Edutar/FC/photo_1_2025-01-22_01-13-42.jpg

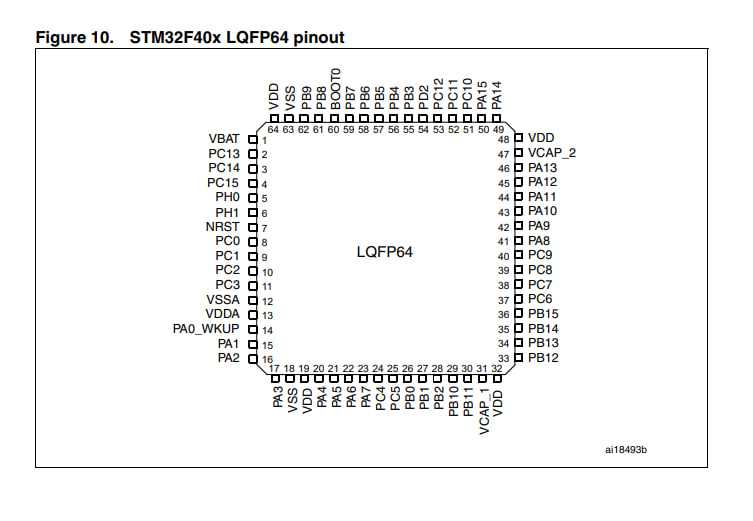
photo_1_2025-01-22_01-13-42.jpg
