Edutar/FC/photo_2_2025-01-22_01-13-42.jpg

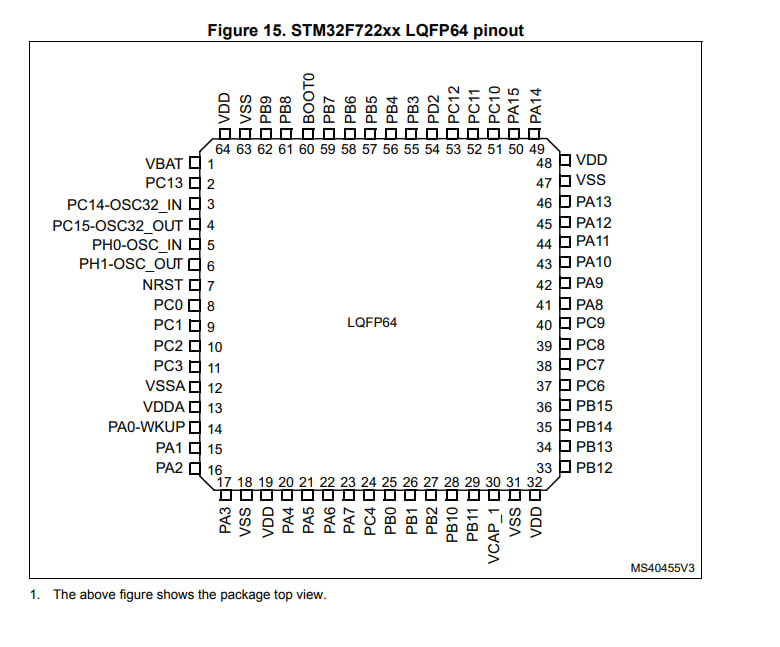
photo_2_2025-01-22_01-13-42.jpg
