Edutar/FC/photo_3_2025-01-22_01-13-42.jpg

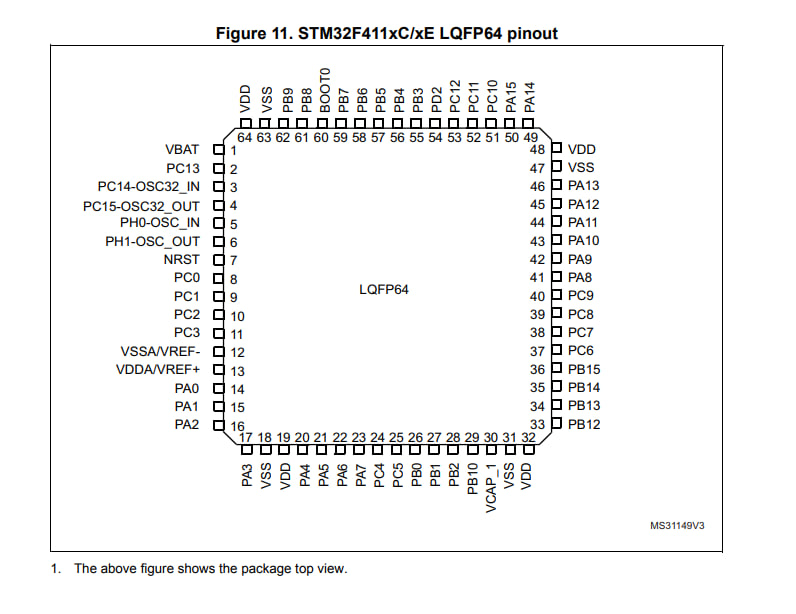
photo_3_2025-01-22_01-13-42.jpg
