Edutar/FC/photo_4_2025-01-22_01-13-42.jpg

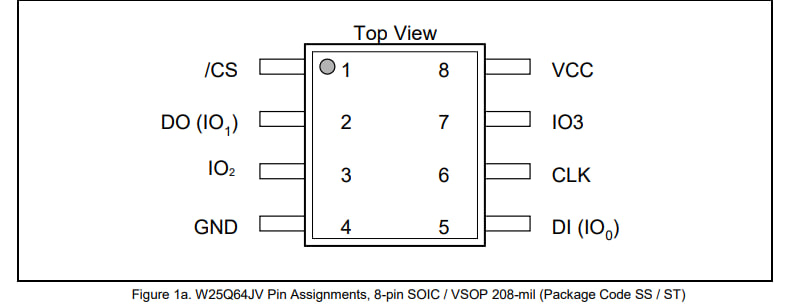
photo_4_2025-01-22_01-13-42.jpg
