Edutar/FC/photo_5_2025-01-22_01-13-42.jpg

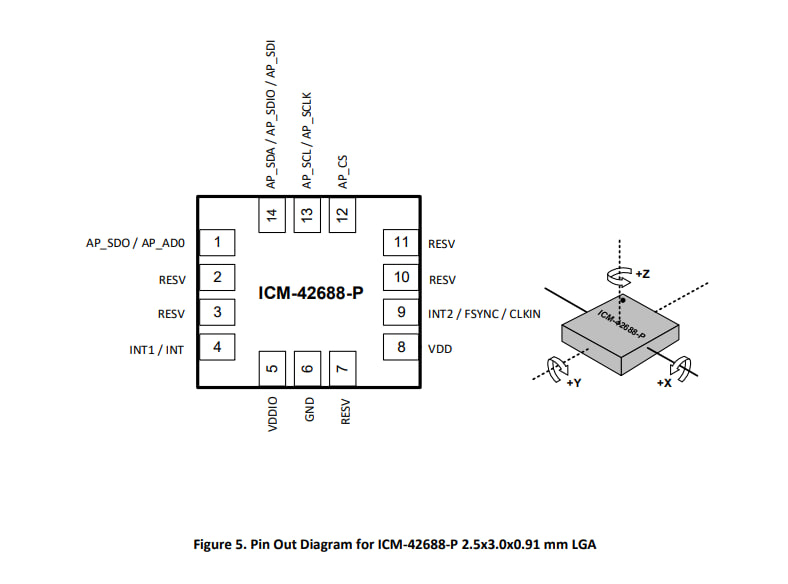
photo_5_2025-01-22_01-13-42.jpg
