Edutar/FC/photo_6_2025-01-22_01-13-42.jpg

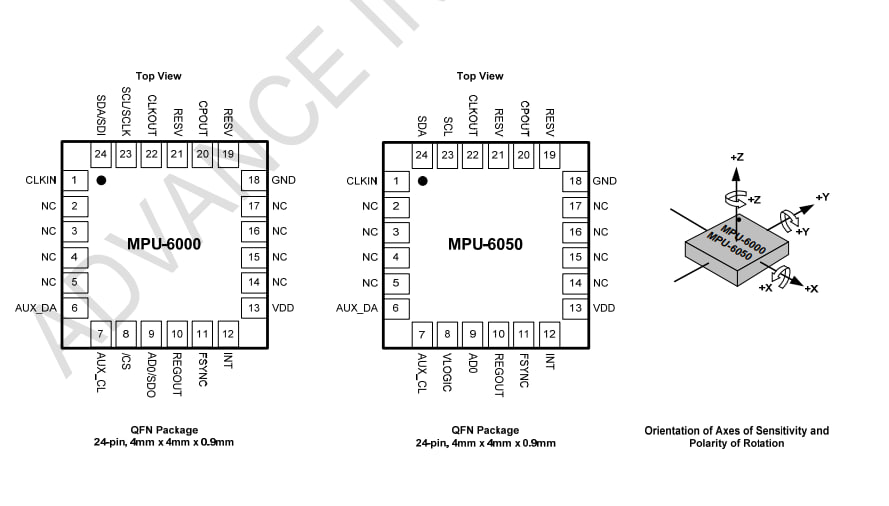
photo_6_2025-01-22_01-13-42.jpg
