Edutar/FC/photo_7_2025-01-22_01-13-42.jpg

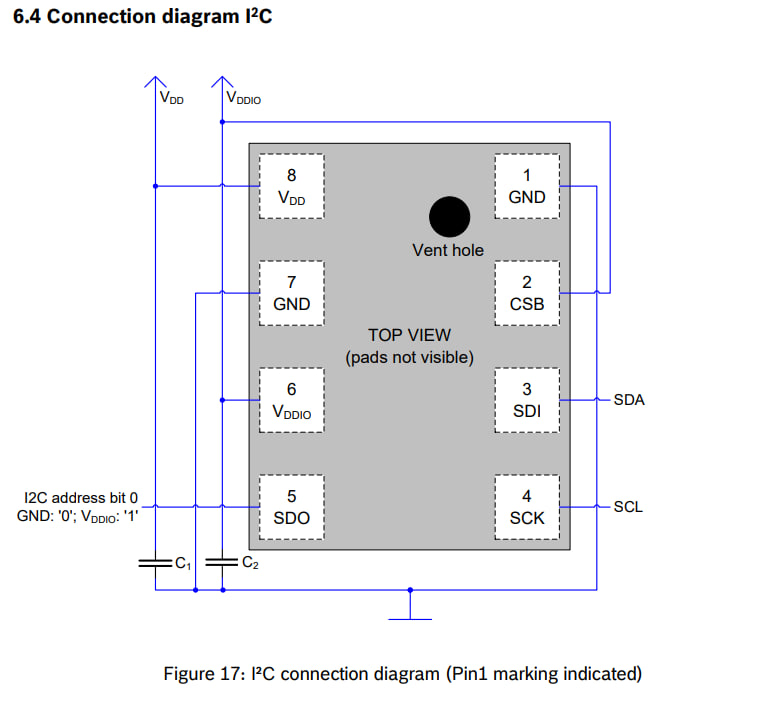
photo_7_2025-01-22_01-13-42.jpg
