Edutar/FC/photo_8_2025-01-22_01-13-42.jpg

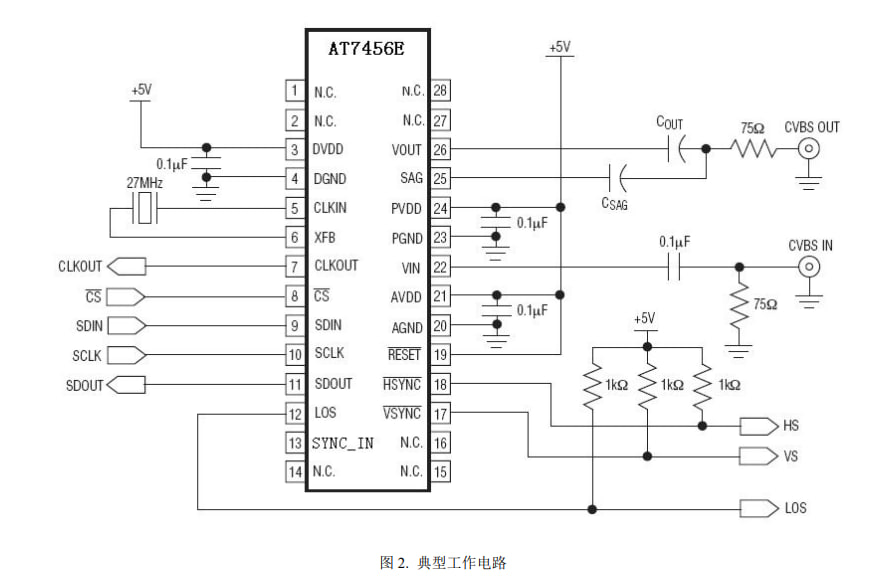
photo_8_2025-01-22_01-13-42.jpg
