Edutar/FC/photo_9_2025-01-22_01-13-42.jpg

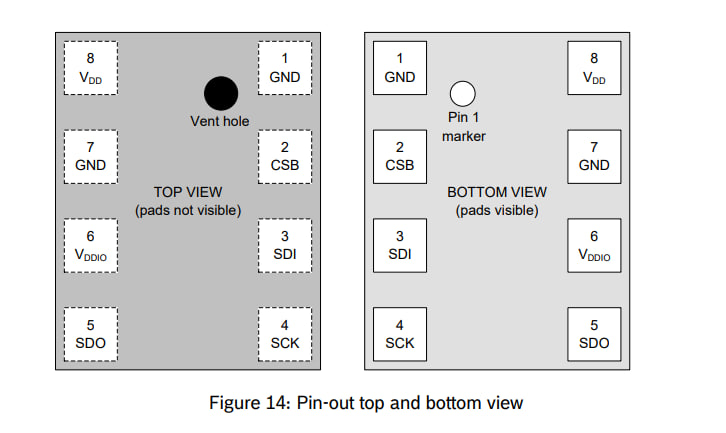
photo_9_2025-01-22_01-13-42.jpg
