Edutar/FC/pcb/AT7456E/AT7456E/3D/AT7456E.stp

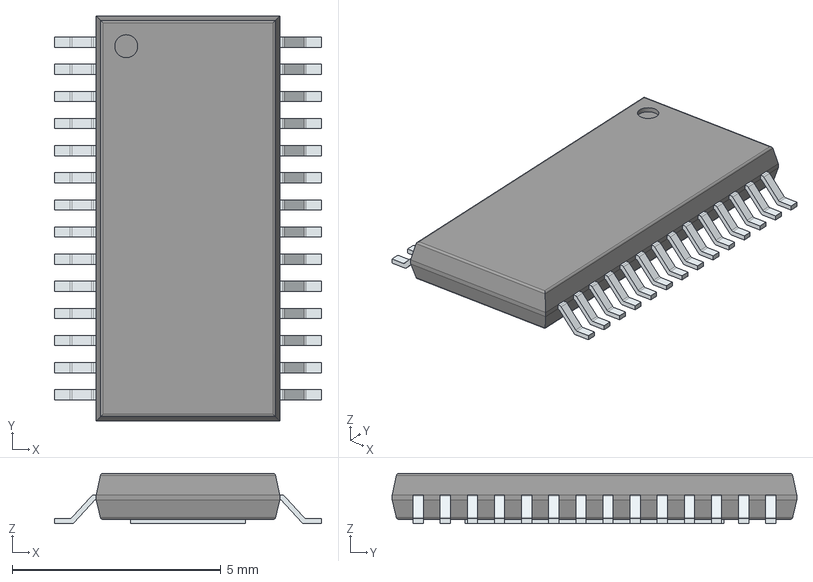
[picture p10: CAD file, 2025-05-21]
pcb/AT7456E/AT7456E/3D/AT7456E.stp
6.40 x 9.70 x 1.20 mm
PinsArrayLR
ThermalPad
