Edutar/FC/pcb/Crystal/ASV-27.000MHZ-EJ-T/ASV-27.000MHZ-EJ-T.step

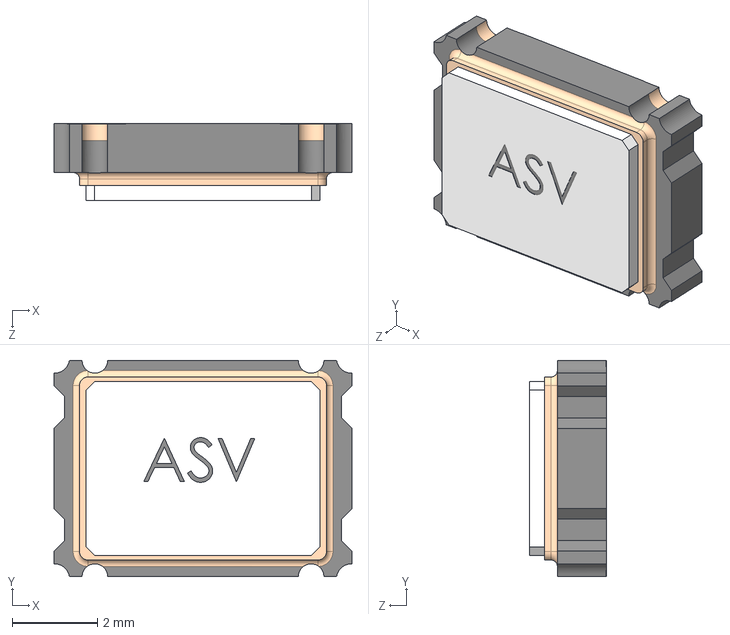
[picture p11: CAD file, 2025-05-21]
pcb/Crystal/ASV-27.000MHZ-EJ-T/ASV-27.000MHZ-EJ-T.step
7.00 x 5.08 x 1.80 mm
