Edutar/FC/pcb/crystal2/C5S-8.000-16-3030-X-R/C5S-8.000-16-3030-X-R.step

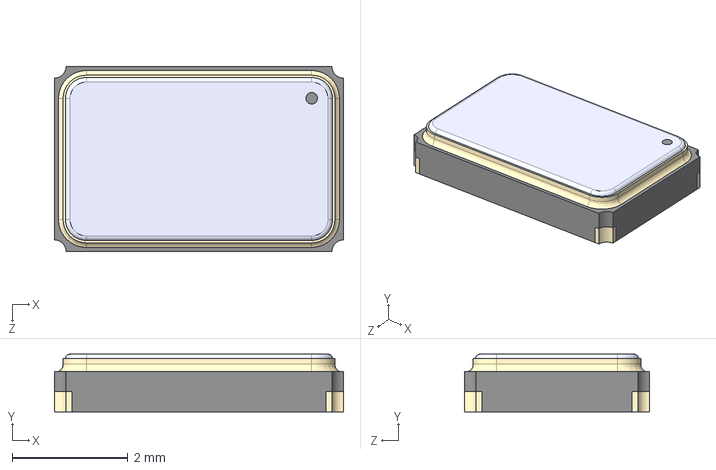
[picture p12: CAD file, 2025-05-21]
pcb/crystal2/C5S-8.000-16-3030-X-R/C5S-8.000-16-3030-X-R.step
5.00 x 1.00 x 3.20 mm
