Edutar/FC/pcb/ICM-42688/ICM-45686/ICM-45686.step

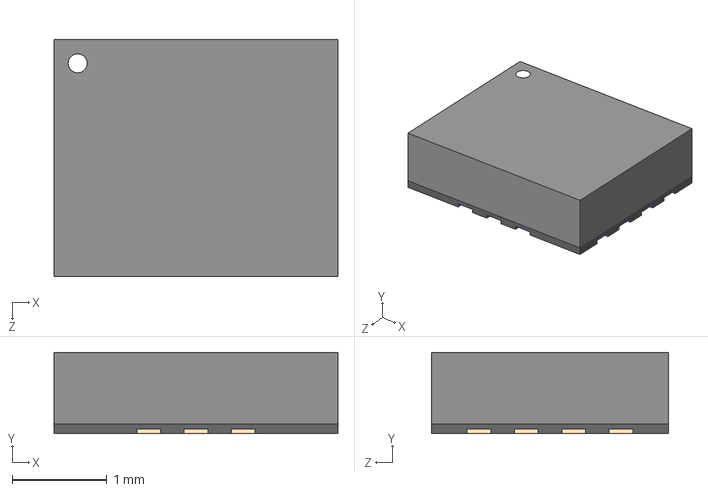
[picture p13: CAD file, 2025-05-21]
pcb/ICM-42688/ICM-45686/ICM-45686.step
3.00 x 0.86 x 2.50 mm
