Edutar/FC/pcb/inductance/F1D1-060603W-100M/F1D1-060603W-100M.step

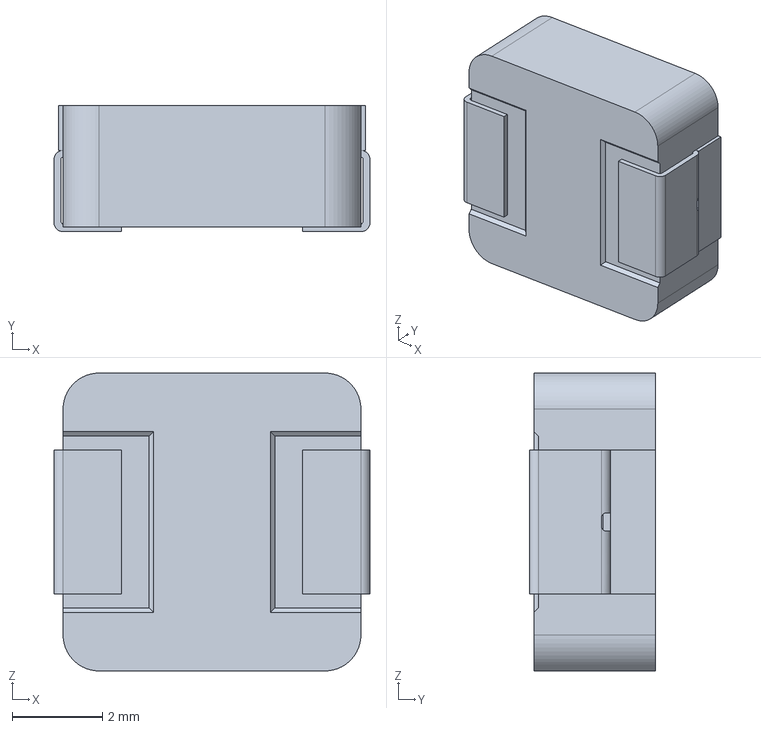
[picture p14: CAD file, 2025-05-21]
pcb/inductance/F1D1-060603W-100M/F1D1-060603W-100M.step
7.00 x 2.80 x 6.60 mm
