Edutar/FC/pcb/MAX4544EUT/MAX4544EUT_T/MAX4544EUT_T.step

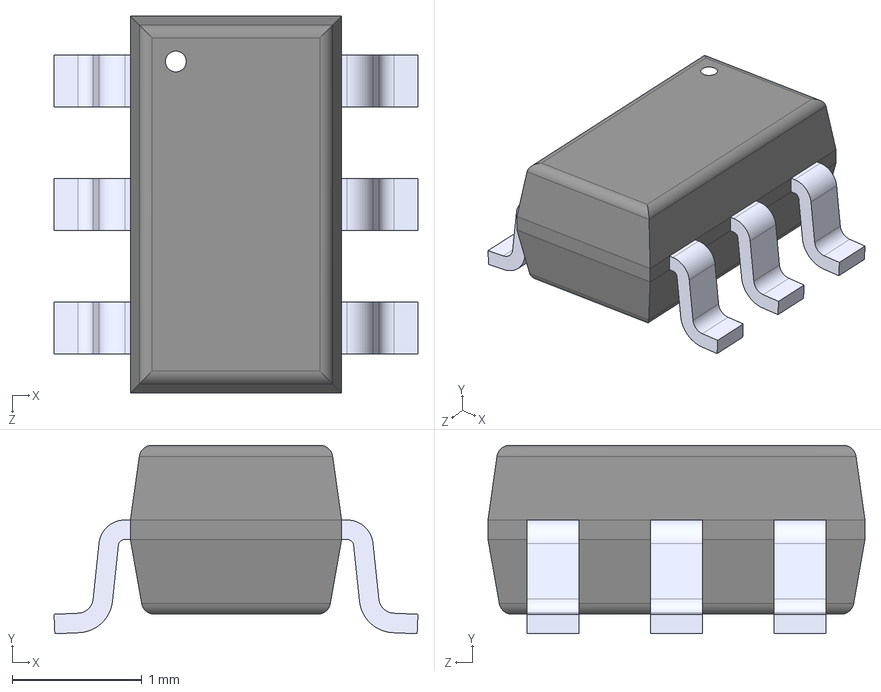
[picture p15: CAD file, 2025-05-21]
pcb/MAX4544EUT/MAX4544EUT_T/MAX4544EUT_T.step
2.80 x 1.45 x 2.90 mm
