Edutar/FC/pcb/MP1584EN/MP1584EN.step

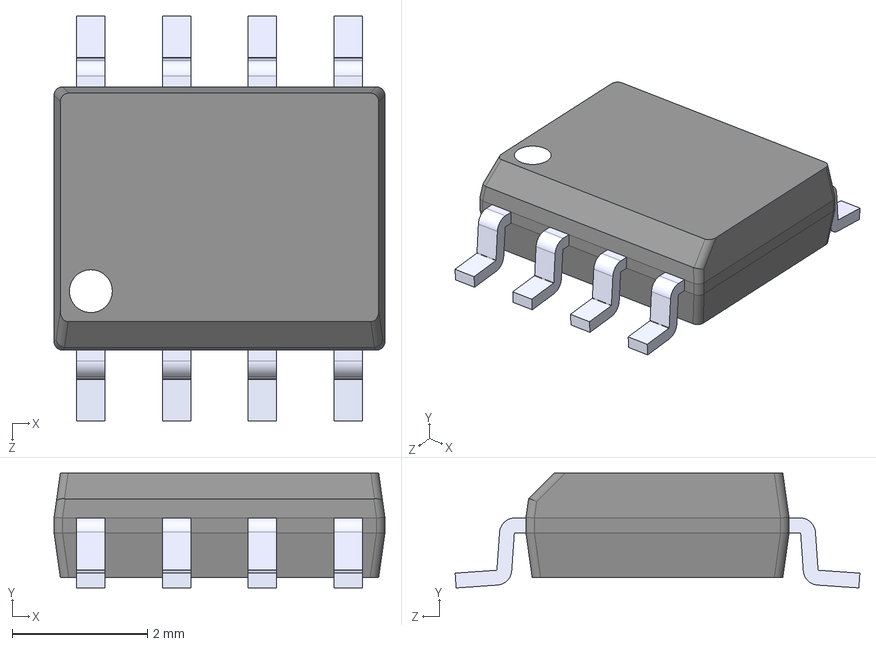
[picture p16: CAD file, 2025-05-21]
pcb/MP1584EN/MP1584EN.step
4.90 x 1.70 x 5.99 mm
