Edutar/FC/(list of files, cad)

Other CAD files:
pcb/AT7456E/AT7456E/Allegro/sop65p640x120-29n.psm
pcb/AT7456E/AT7456E/DEHDL/at7456e/chips/chips.prt
