Edutar/FC/Збірка під stellar PCB/Збірка/Збірка.kicad_pcb

## KiCad design Збірка під stellar PCB/Збірка/Збірка.kicad_pcb (2025-05-21)

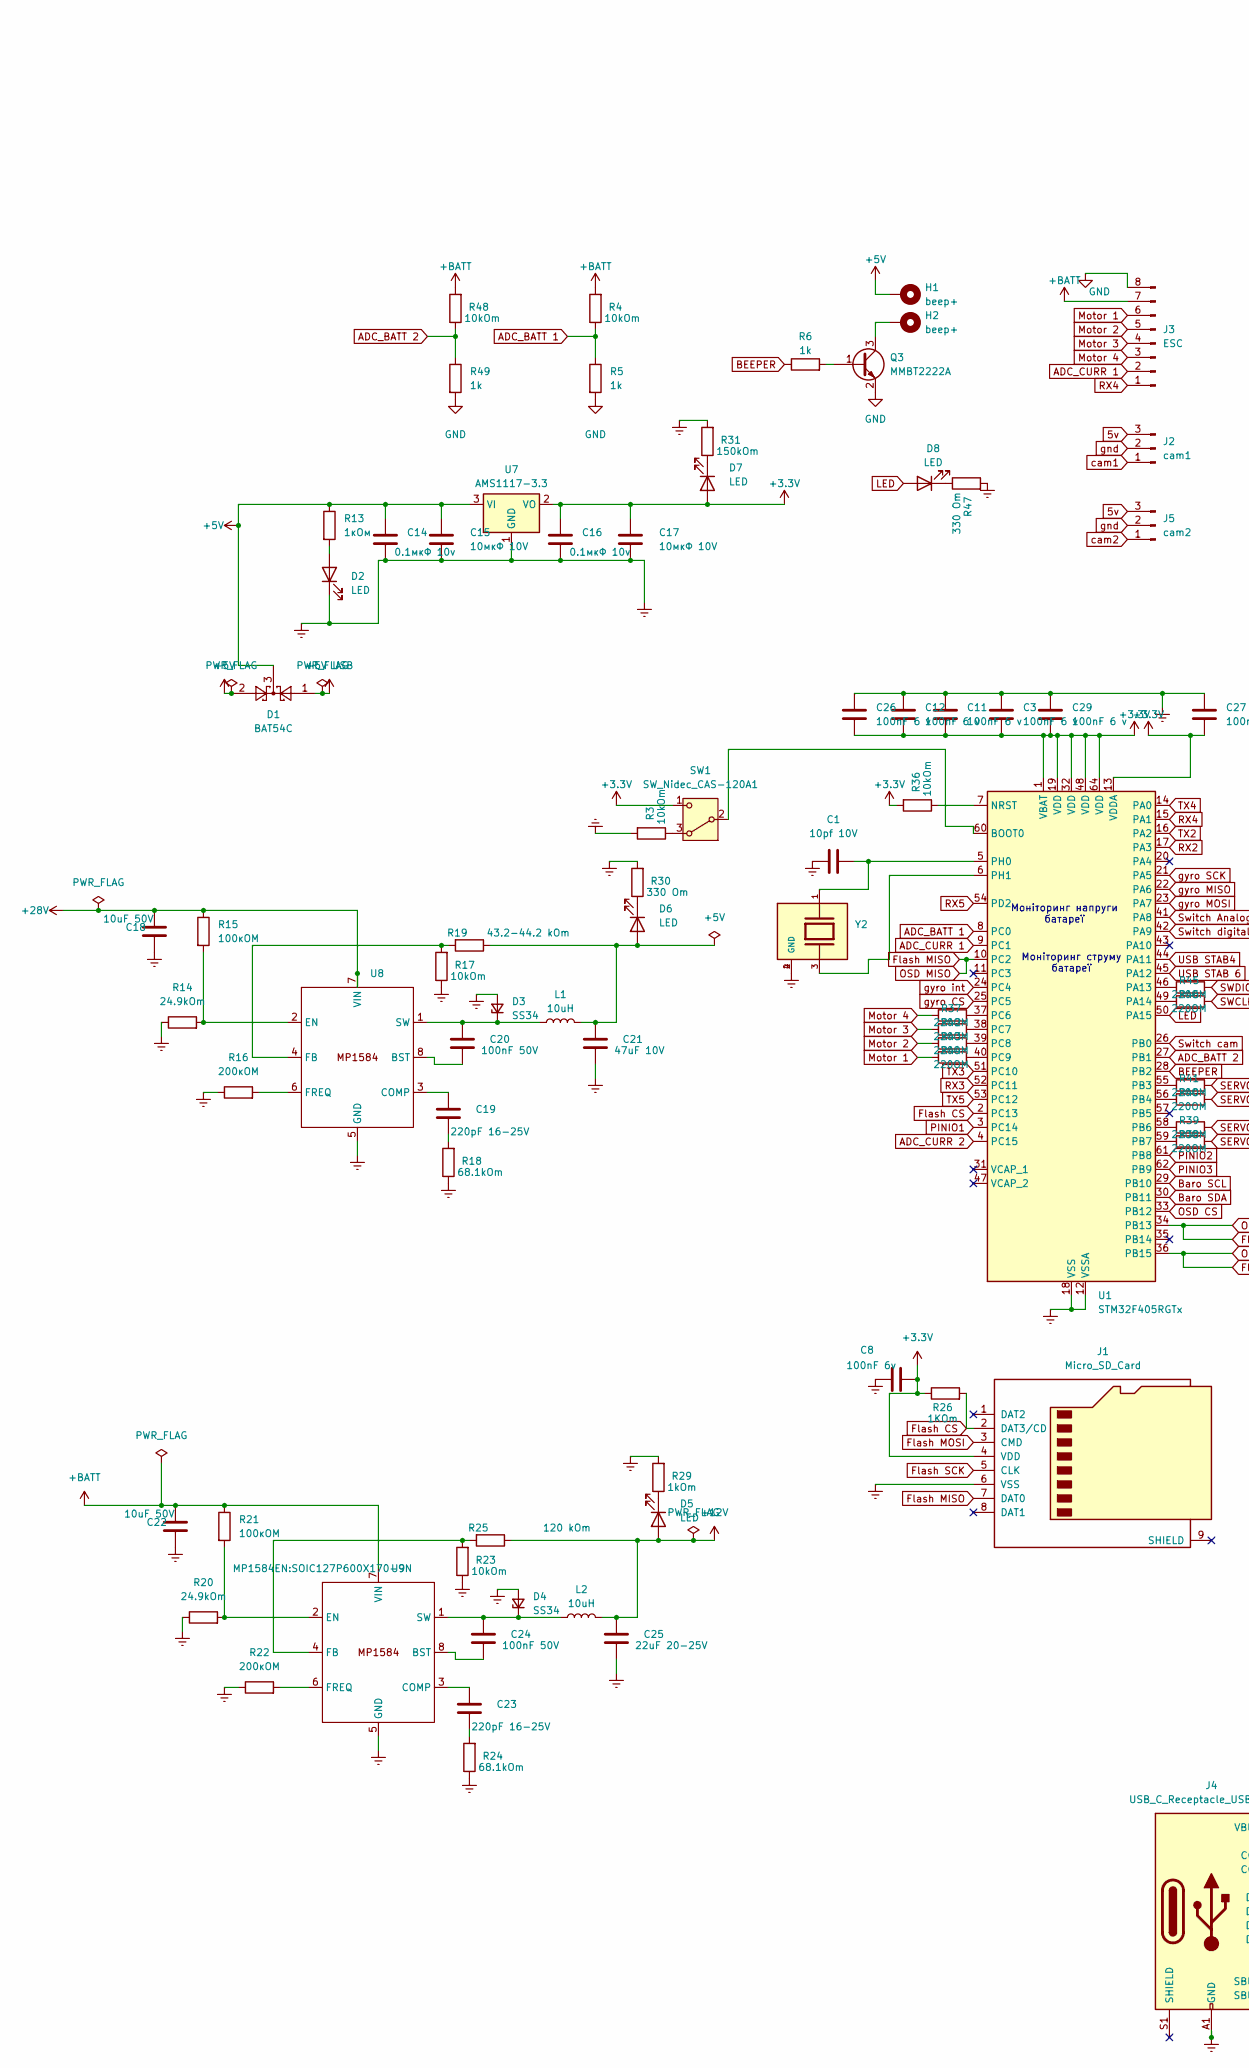
[picture p17: schematic Збірка.kicad_sch, part in row 1, column 1]

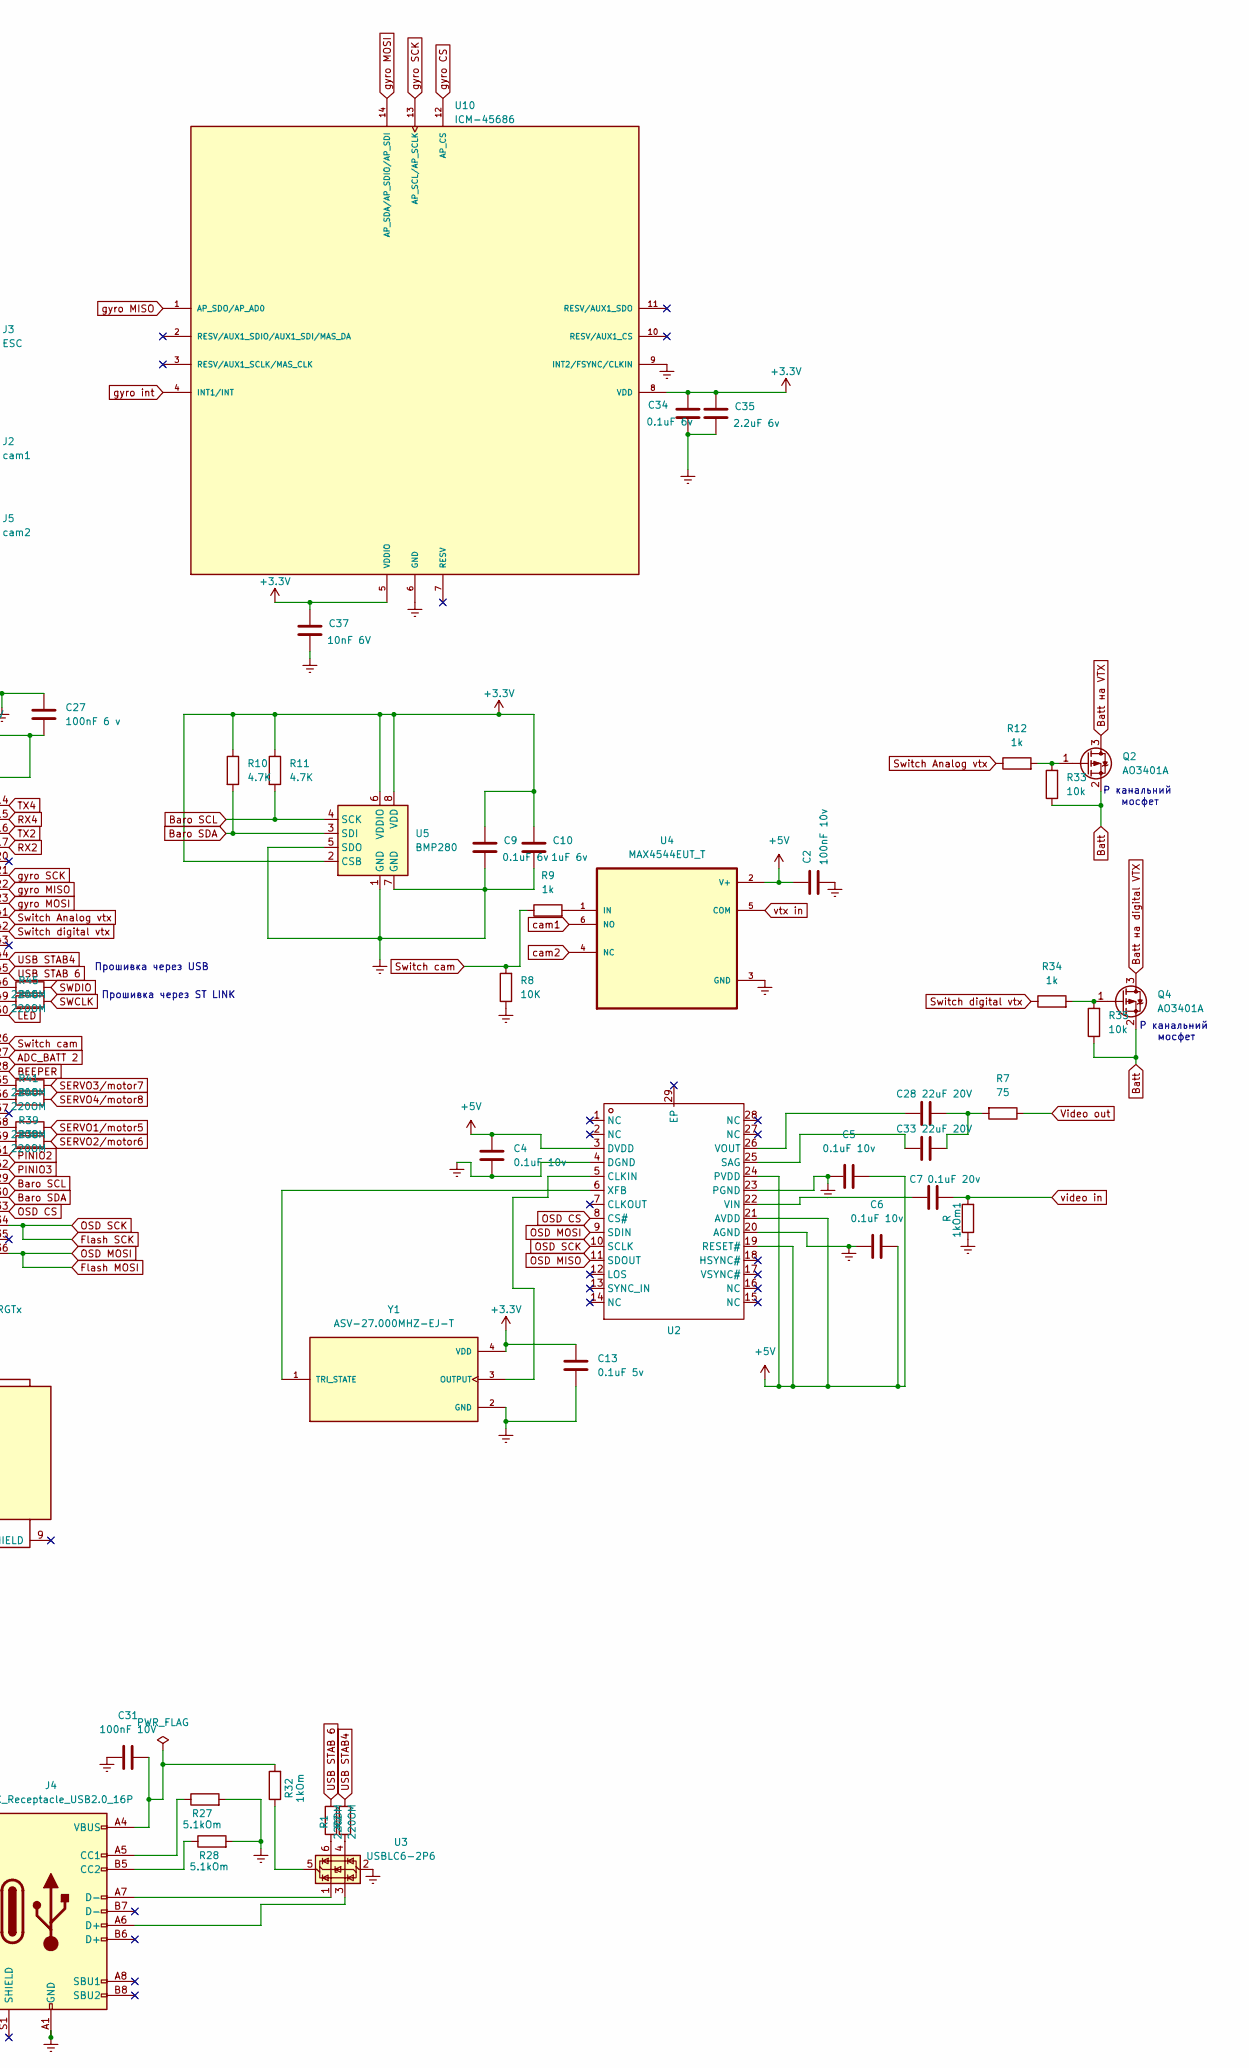
[picture p18: schematic Збірка.kicad_sch, part in row 1, column 2]

Parts:
1kOm1: R; R_0402_1005Metric_Pad0.72x0.64mm_HandSolder
C1: 10pf 10V; C_0603_1608Metric_Pad1.08x0.95mm_HandSolder
C2: 100nF 10v; C_0603_1608Metric
C3, C11, C12, C26, C27, C29: 100nF 6 v; C_0603_1608Metric
C4, C5, C6: 0.1uF 10v; C_0805_2012Metric_Pad1.18x1.45mm_HandSolder
C7: 0.1uF 20v; C_0805_2012Metric
C8: 100nF 6v; C_0402_1005Metric
C9: 0.1uF 6v; C_0603_1608Metric
C10: 1uF 6v; C_0603_1608Metric
C13: 0.1uF 5v; C_0603_1608Metric
C14, C16: 0.1мкФ 10v; C_0603_1608Metric
C15, C17: 10мкФ 10V; C_0805_2012Metric
C18, C22: 10uF 50V; C_1210_3225Metric
C19, C23: 220pF 16-25V; C_1206_3216Metric
C20, C24: 100nF 50V; C_1210_3225Metric
C21: 47uF 10V; C_0805_2012Metric_Pad1.18x1.45mm_HandSolder
C25: 22uF 20-25V; C_1206_3216Metric
C28, C33: 22uF 20V; C_0805_2012Metric_Pad1.18x1.45mm_HandSolder
C31: 100nF 10V; C_0805_2012Metric
C34: 0.1uF 6v; C_0402_1005Metric
C35: 2.2uF 6v; C_0402_1005Metric
C37: 10nF 6V; C_0603_1608Metric
D1: BAT54C; SOT-23
D2, D5, D6, D7, D8: LED; LED_0402_1005Metric
D3, D4: SS34; D_SMA
H1, H2: beep+; SolderWirePad_1x01_SMD_1x2mm
J1: Micro_SD_Card; microSD_HC_Molex_47219-2001
J2: cam1; Samtec_T1M-03-X-S-RA_1x03-1MP_P1.0mm_Terminal_Horizontal
J3: ESC; Molex_200528-0080_1x08-1MP_P1.00mm_Horizontal
J4: USB_C_Receptacle_USB2.0_16P; USB_C_Receptacle_GCT_USB4105-xx-A_16P_TopMnt_Horizontal
J5: cam2; Samtec_T1M-03-X-S-RA_1x03-1MP_P1.0mm_Terminal_Horizontal
L1, L2: 10uH; IND_F1D1-060603W-100M
Q2, Q4: AO3401A; SOT-23
Q3: MMBT2222A; SOT-23
R1, R2, R37, R38, R39, R40, R41, R42, R43, R44, R45, R46: 220OM; R_0201_0603Metric
R3, R4, R17, R23, R36, R48: 10kOm; R_0402_1005Metric_Pad0.72x0.64mm_HandSolder
R5, R6, R9, R12, R34, R49: 1k; R_0201_0603Metric
R7: 75; R_0201_0603Metric
R8: 10K; R_0402_1005Metric_Pad0.72x0.64mm_HandSolder
R10, R11: 4.7K; R_0402_1005Metric
R13: 1кОм; R_0402_1005Metric_Pad0.72x0.64mm_HandSolder
R14, R20: 24.9kOm; R_0402_1005Metric_Pad0.72x0.64mm_HandSolder
R15: 100кОМ; R_0603_1608Metric_Pad0.98x0.95mm_HandSolder
R16, R22: 200кОМ; R_0603_1608Metric_Pad0.98x0.95mm_HandSolder
R18, R24: 68.1kOm; R_0402_1005Metric_Pad0.72x0.64mm_HandSolder
R19: 43.2-44.2 kOm; R_0603_1608Metric
R21: 100кОМ; R_0603_1608Metric
R25: 120 kOm; R_0603_1608Metric
R26: 1KOm; R_0402_1005Metric_Pad0.72x0.64mm_HandSolder
R27, R28: 5.1kOm; R_0402_1005Metric
R29, R32: 1kOm; R_0201_0603Metric
R30, R47: 330 Om; R_0201_0603Metric
R31: 150kOm; R_0201_0603Metric
R33, R35: 10k; R_0402_1005Metric_Pad0.72x0.64mm_HandSolder
SW1: SW_Nidec_CAS-120A1; Nidec_Copal_CAS-120A
U1: STM32F405RGTx; LQFP-64_10x10mm_P0.5mm
U2: SOP65P640X120-29N; Manufacturer Part AT7456E; LCSC Part Name AT7456E
U3: USBLC6-2P6; SOT-666
U4: MAX4544EUT_T; SOT95P280X145-6N
U5: BMP280; Bosch_LGA-8_2x2.5mm_P0.65mm_ClockwisePinNumbering
U7: AMS1117-3.3; SOT-223-3_TabPin2
U8, U9: SOIC127P600X170-9N
U10: ICM-45686; IC_ICM-45686; PARTREV 0.2
Y1: ASV-27.000MHZ-EJ-T; XTAL_ASV-27.000MHZ-EJ-T; PARTREV 09.02.14
Y2: C5S-8.000-16-3030-X-R; XTAL_C5S-8.000-16-3030-X-R; PARTREV N/A

Connections:
5v: J2.3, J5.3
+3.3V: C3.1, C8.2, C9.1, C10.1, C11.1, C12.1, C13.1, C16.1, C17.1, C26.1, C27.1, C29.1, C34.1, C35.1, C37.1, D7.2 (A), J1.4 (VDD), R10.1, R11.1, R26.1, R36.2, SW1.1 (C), U1.1 (VBAT), U1.13 (VDDA), U1.19 (VDD), U1.32 (VDD), U1.48 (VDD), U1.64 (VDD), U5.2 (CSB), U5.6 (VDDIO), U5.8 (VDD), U7.2 (VO), U10.5 (VDDIO), U10.8 (VDD), Y1.4 (VDD)
+5V: C2.1, C4.1, C5.2, C6.2, C14.1, C15.1, D1.2, D1.3, H1.1, R13.1, U2.3 (DVDD), U2.19 (RESET#), U2.21 (AVDD), U2.24 (PVDD), U4.2 (V+), U7.3 (VI)
+5V USB: D1.1
+12V: C25.1, D5.2 (A), L2.2, R25.1
+28V: C18.1, R15.1, U8.7 (VIN)
+BATT: C22.1, J3.7, R4.2, R21.1, R48.2, U9.7 (VIN)
<NO NET>: 1kOm1.1, C1.2, C2.2, C3.2, C4.2, C5.1, C6.1, C8.1, C9.2, C10.2, C11.2, C12.2, C13.2, C14.2, C15.2, C16.2, C17.2, C26.2, C27.2, C29.2, C31.2, D2.1 (K), J1.6 (VSS), J4.A1 (GND), J4.A12 (GND), J4.B1 (GND), J4.B12 (GND), R3.2, R8.1, U1.12 (VSSA), U1.18 (VSS), U1.63 (VSS), U2.4 (DGND), U2.20 (AGND), U2.23 (PGND), U4.3 (GND), U5.1 (GND), U5.5 (SDO), U5.7 (GND), U7.1 (GND), Y1.2 (GND)
ADC_BATT 1: R4.1, R5.1, U1.8 (PC0)
ADC_BATT 2: R48.1, R49.1, U1.27 (PB1)
ADC_CURR 1: J3.2, U1.9 (PC1)
ADC_CURR 2: U1.4 (PC15)
BEEPER: R6.1, U1.28 (PB2)
Baro SCL: R11.2, U1.29 (PB10), U5.4 (SCK)
Baro SDA: R10.2, U1.30 (PB11), U5.3 (SDI)
Batt: Q2.2 (S), Q4.2 (S), R33.1, R35.1
Batt на VTX: Q2.3 (D)
Batt на digital VTX: Q4.3 (D)
Earth: C18.2, C21.2, C22.2, C25.2, C34.2, C35.2, C37.2, D3.2 (A), D4.2 (A), R14.1, R16.1, R17.1, R18.1, R20.1, R22.1, R23.1, R24.1, R27.2, R28.2, R29.2, R30.2, R31.2, R47.2, U3.2 (GND), U8.5 (GND), U9.5 (GND), U10.6 (GND), U10.9 (INT2/FSYNC/CLKIN), Y2.2 (GND), Y2.4 (GND)
Flash CS: J1.2 (DAT3/CD), R26.2, U1.2 (PC13)
Flash MISO: J1.7 (DAT0), U1.10 (PC2), U2.11 (SDOUT)
Flash MOSI: J1.3 (CMD), U1.36 (PB15), U2.9 (SDIN)
Flash SCK: J1.5 (CLK), U1.34 (PB13), U2.10 (SCLK)
GND: J3.8, Q3.2 (E), R5.2, R49.2
LED: D8.2 (A), U1.50 (PA15)
Motor 1: J3.6, R44.1
Motor 2: J3.5, R43.1
Motor 3: J3.4, R42.1
Motor 4: J3.3, R37.1
unnamed: C19.2, R18.2
unnamed: C23.2, R24.2
unnamed: C28.1, C33.1, R7.2
unnamed: C31.1, J4.A4 (VBUS), J4.A9 (VBUS), J4.B4 (VBUS), J4.B9 (VBUS), R32.2
unnamed: D2.2 (A), R13.2
unnamed: C20.1, D3.1 (K), L1.1, U8.1 (SW)
unnamed: C24.1, D4.1 (K), L2.1, U9.1 (SW)
unnamed: D5.1 (K), R29.1
unnamed: C21.1, D6.2 (A), L1.2, R19.1
unnamed: D6.1 (K), R30.1
unnamed: D7.1 (K), R31.1
unnamed: D8.1 (K), R47.1
unnamed: J4.A5 (CC1), R27.1
unnamed: J4.B5 (CC2), R28.1
unnamed: J4.A6 (D+), U3.3 (I/O2)
unnamed: J4.A7 (D-), U3.1 (I/O1)
unnamed: Q2.1 (G), R12.2, R33.2
unnamed: Q3.1 (B), R6.2
unnamed: H2.1, Q3.3 (C)
unnamed: Q4.1 (G), R34.2, R35.2
unnamed: R1.1, U3.6 (I/O1)
unnamed: R2.1, U3.4 (I/O2)
unnamed: R3.1, SW1.3 (A)
unnamed: SW1.2 (B), U1.60 (BOOT0)
unnamed: R36.1, U1.7 (NRST)
unnamed: R45.1, U1.46 (PA13)
unnamed: R46.1, U1.49 (PA14)
unnamed: R41.1, U1.55 (PB3)
unnamed: R40.1, U1.56 (PB4)
unnamed: R39.1, U1.58 (PB6)
unnamed: R38.1, U1.59 (PB7)
unnamed: R37.2, U1.37 (PC6)
unnamed: R42.2, U1.38 (PC7)
unnamed: R43.2, U1.39 (PC8)
unnamed: R44.2, U1.40 (PC9)
unnamed: C1.1, U1.5 (PH0), Y2.1
unnamed: U1.6 (PH1), Y2.3
unnamed: U2.5 (CLKIN), Y1.3 (OUTPUT)
unnamed: C33.2, U2.25 (SAG)
unnamed: C7.2, U2.22 (VIN)
unnamed: C28.2, U2.26 (VOUT)
unnamed: U2.6 (XFB), Y1.1 (TRI_STATE)
unnamed: R32.1, U3.5 (VBUS)
unnamed: R9.2, U4.1 (IN)
unnamed: C20.2, U8.8 (BST)
unnamed: C19.1, U8.3 (COMP)
unnamed: R14.2, R15.2, U8.2 (EN)
unnamed: R17.2, R19.2, U8.4 (FB)
unnamed: R16.2, U8.6 (FREQ)
unnamed: C24.2, U9.8 (BST)
unnamed: C23.1, U9.3 (COMP)
unnamed: R20.2, R21.2, U9.2 (EN)
unnamed: R23.2, R25.2, U9.4 (FB)
unnamed: R22.2, U9.6 (FREQ)
OSD CS: U1.33 (PB12), U2.8 (CS#)
PINIO1: U1.3 (PC14)
PINIO2: U1.61 (PB8)
PINIO3: U1.62 (PB9)
RX2: U1.17 (PA3)
RX3: U1.52 (PC11)
RX4: J3.1, U1.15 (PA1)
RX5: U1.54 (PD2)
SERVO1/motor5: R39.2
SERVO2/motor6: R38.2
SERVO3/motor7: R41.2
SERVO4/motor8: R40.2
SWCLK: R46.2
SWDIO: R45.2
Switch Analog vtx: R12.1, U1.41 (PA8)
Switch cam: R8.2, R9.1, U1.26 (PB0)
Switch digital vtx: R34.1, U1.42 (PA9)
TX2: U1.16 (PA2)
TX3: U1.51 (PC10)
TX4: U1.14 (PA0)
TX5: U1.53 (PC12)
USB STAB4: R2.2, U1.44 (PA11)
USB STAB 6: R1.2, U1.45 (PA12)
Video out: R7.1
cam1: J2.1, U4.6 (NO)
cam2: J5.1, U4.4 (NC)
gnd: J2.2, J5.2
gyro CS: U1.25 (PC5), U10.12 (AP_CS)
gyro MISO: U1.22 (PA6), U10.1 (AP_SDO/AP_AD0)
gyro MOSI: U1.23 (PA7), U10.14 (AP_SDA/AP_SDIO/AP_SDI)
gyro SCK: U1.21 (PA5), U10.13 (AP_SCL/AP_SCLK)
gyro int: U1.24 (PC4), U10.4 (INT1/INT)
video in: 1kOm1.2, C7.1
vtx in: U4.5 (COM)

Notes on the sheet:
Прошивка через ST LINK
Прошивка через USB
P канальний мосфет
Моніторинг напруги батареї
Моніторинг струму батареї

Board: 6 copper layers, 116 parts (0 on the bottom side), 95 nets, no tracks yet.
