Edutar/FC/(notices)

Notices in the files:
pcb/inductance/F1D1-060603W-100M/F1D1-060603W-100M.step:
author */ ('License CC BY-ND 4.0'),
